jannepetter/hydroponicsMachine/presentations/midterm hydroP.pptx

## HydroponicsMachine

Github repo:
https://github.com/jannepetter/hydroponicsMachine
Sakari Väisänen, Oliver Niskala, Petri Hinttala and Janne Uutela

## Slide 2

Sketching

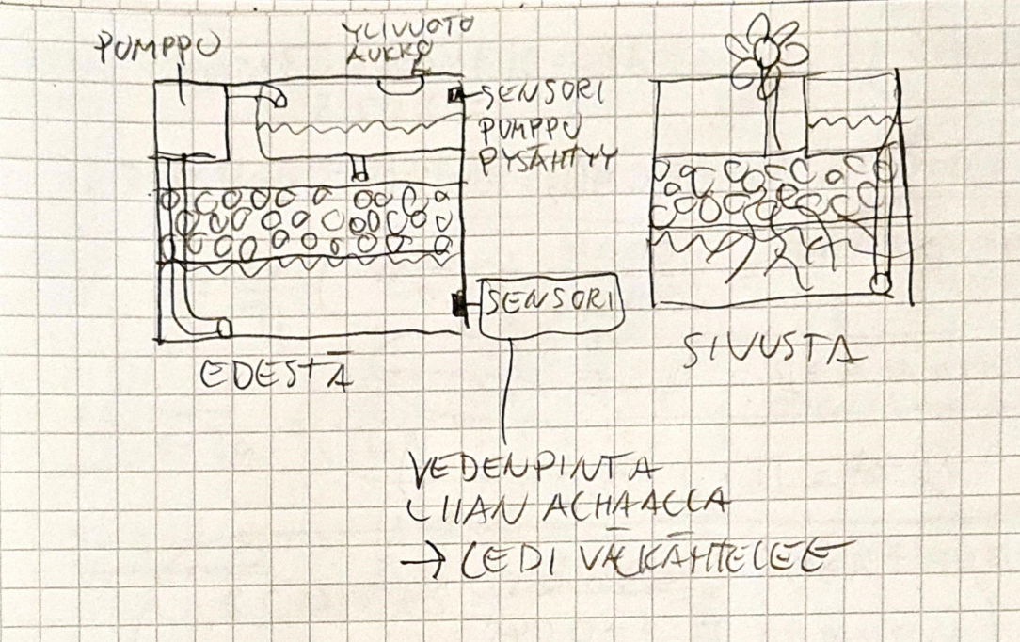
[picture p1: figure]
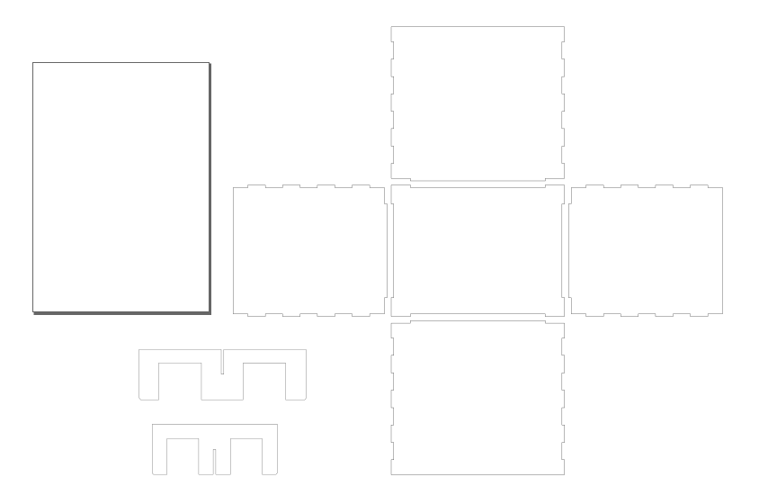
[picture p2: figure]

- maintank

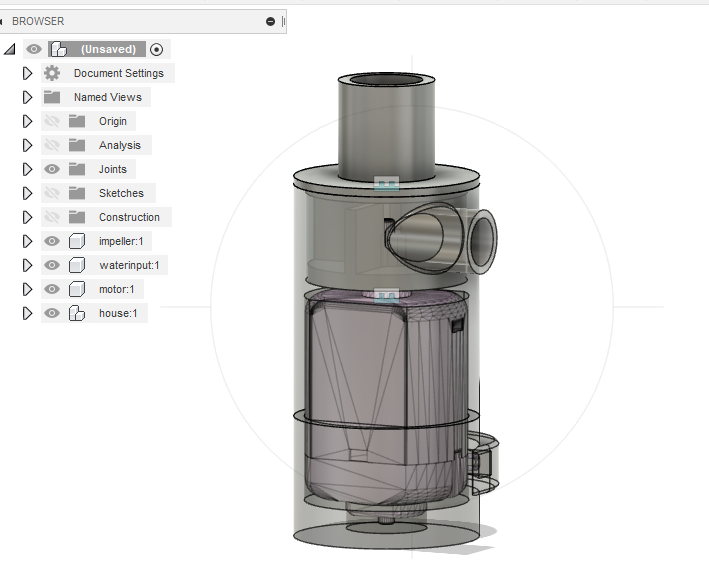
[picture p3: figure]

- pump

- minitank

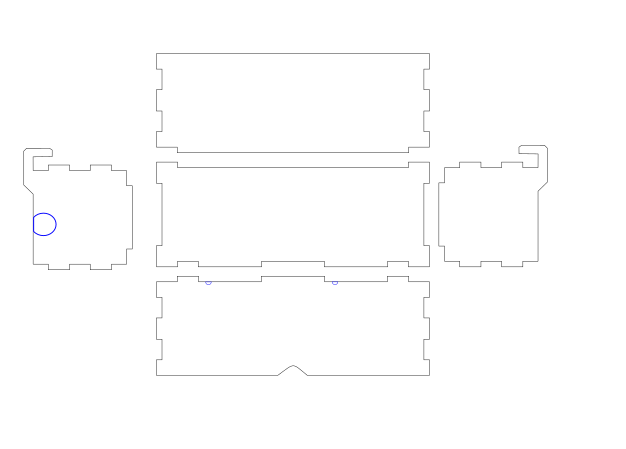
[picture p4: figure]

## Slide 3

Assembled main and minitank

- Holds water!
- We had minor cracks while gluing it together. (Kerf 0,18 and joint clearance 0,001). We will be using greater clearance for rest of the parts

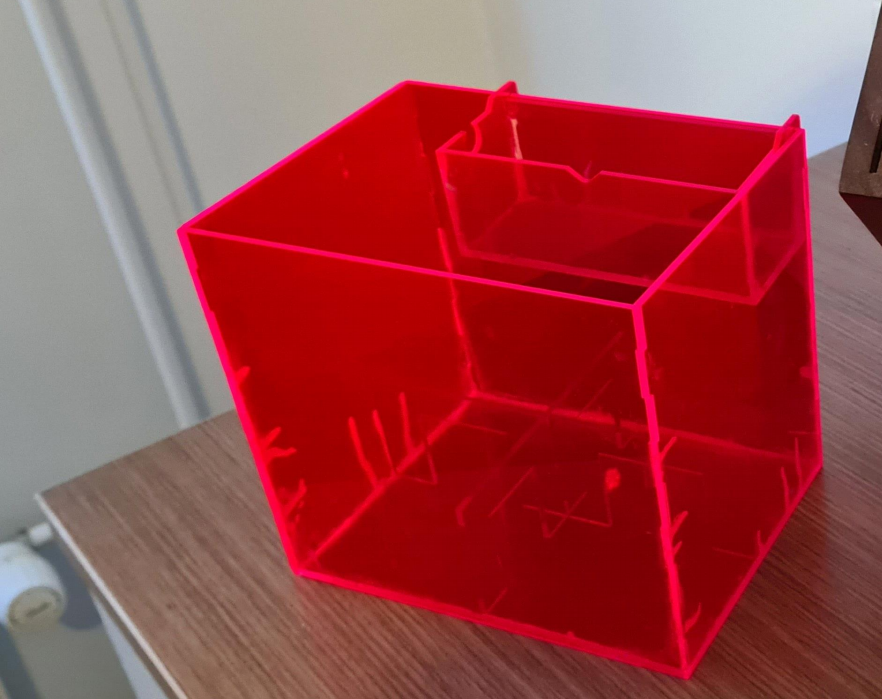
[picture p5: figure]
Kuva, joka sisältää kohteen teksti, pöytä, sisä, lattia Kuvaus luotu automaattisesti
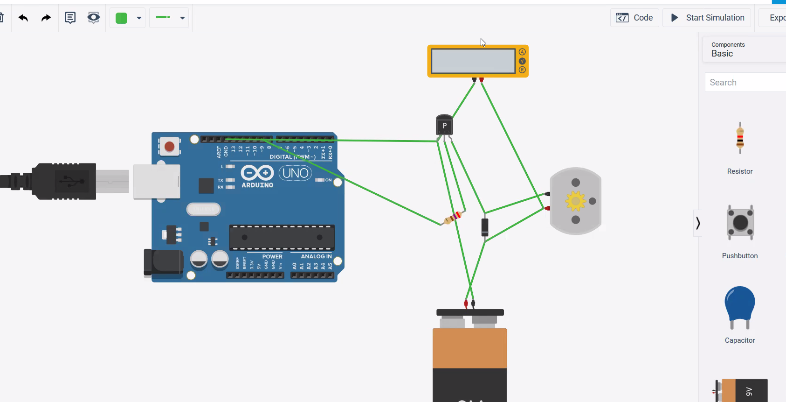
[picture p6: figure]

Current plan for the electronics
