jannepetter/hydroponicsMachine/3Dwaterpump/waterpumpv_inlet2.stl

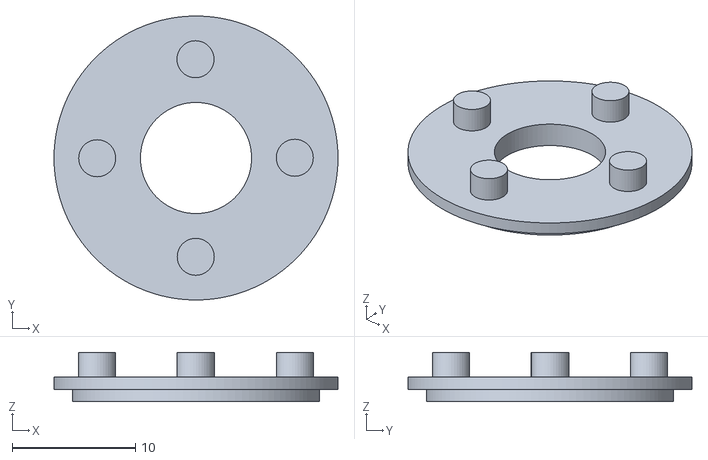
[picture p7: CAD file, 2021-04-11]
3Dwaterpump/waterpumpv_inlet2.stl
23.0 x 23.0 x 4.00
