jannepetter/hydroponicsMachine/3Dwaterpump/waterpumpv_inlet1.stl

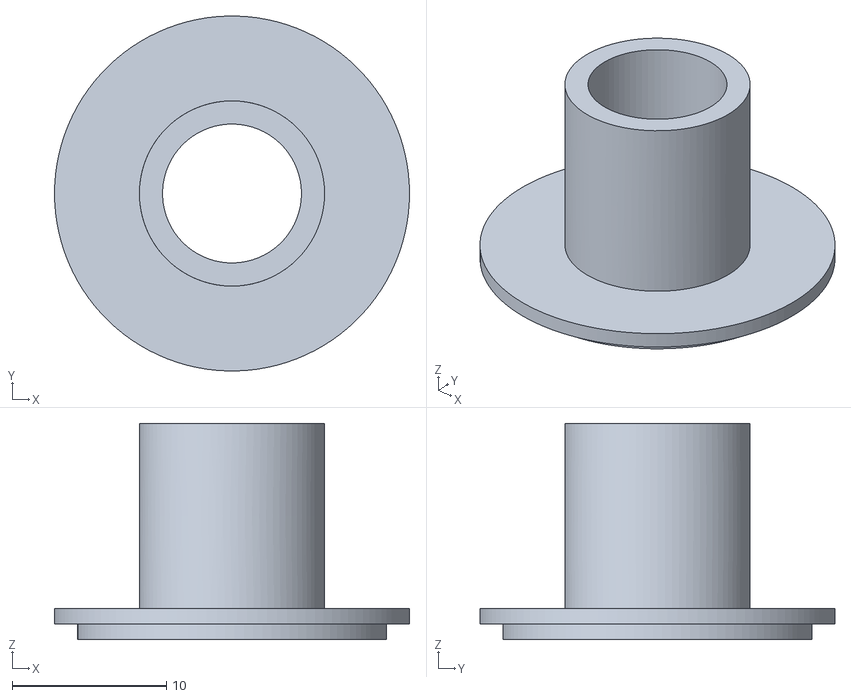
[picture p8: CAD file, 2021-04-11]
3Dwaterpump/waterpumpv_inlet1.stl
23.0 x 23.0 x 14.0
