jannepetter/hydroponicsMachine/3Dwaterpump/waterpumpv_impeller.stl

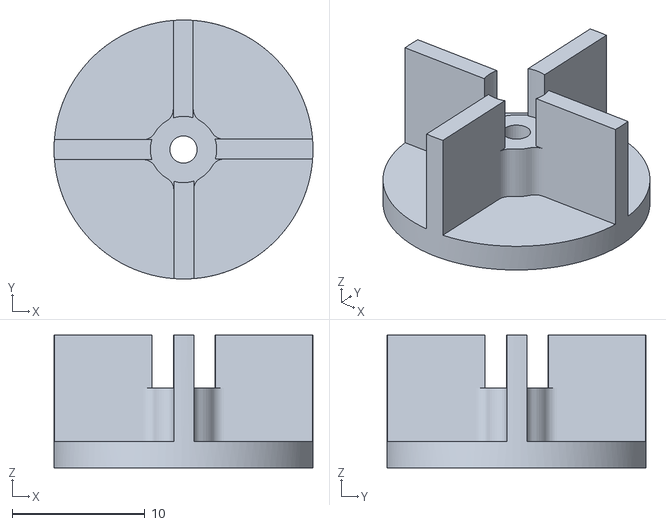
[picture p9: CAD file, 2021-04-11]
3Dwaterpump/waterpumpv_impeller.stl
19.5 x 19.5 x 10.0
