jannepetter/hydroponicsMachine/3Dwaterpump/waterpumpv_house.stl

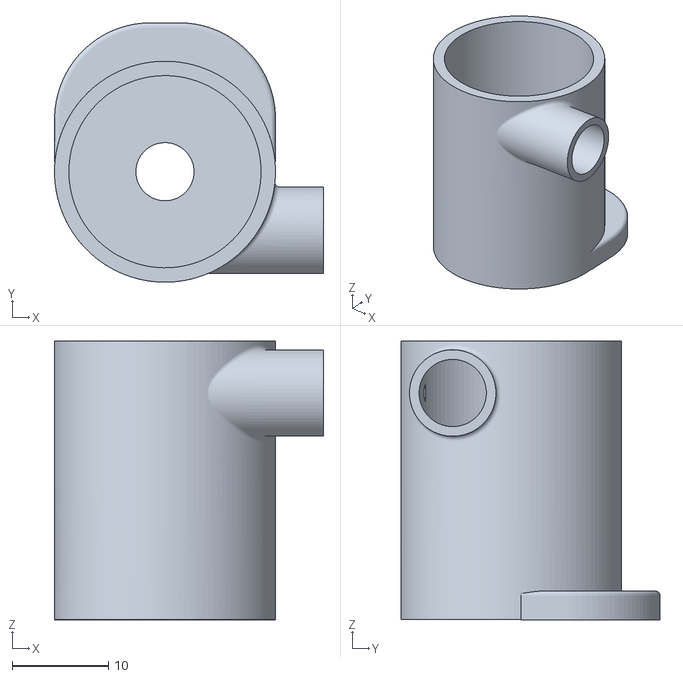
[picture p10: CAD file, 2021-04-11]
3Dwaterpump/waterpumpv_house.stl
28.0 x 27.0 x 29.0
