jannepetter/hydroponicsMachine/3Dwaterpump/waterpumpv_cover.stl

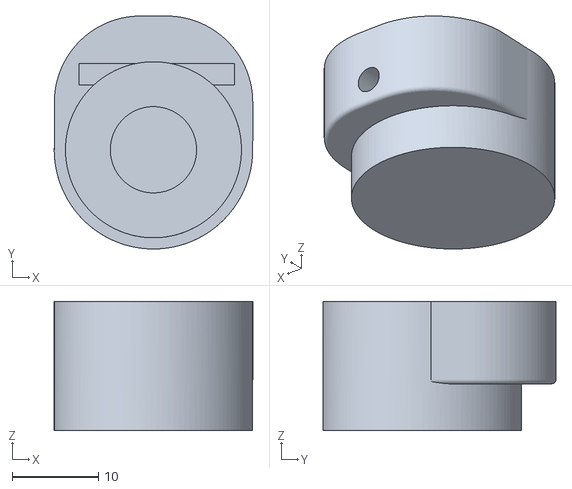
[picture p11: CAD file, 2021-04-11]
3Dwaterpump/waterpumpv_cover.stl
23.0 x 27.0 x 15.0
