jannepetter/hydroponicsMachine/(list of files, cad)

Other CAD files:
3Dwaterpump/waterpump.f3d
