jannepetter/hydroponicsMachine/kicad_hydroponics_cirtuit_test/kicad_hydroponics_cirtuit_test.kicad_pcb

## KiCad design kicad_hydroponics_cirtuit_test/kicad_hydroponics_cirtuit_test.kicad_pcb (2021-04-26)

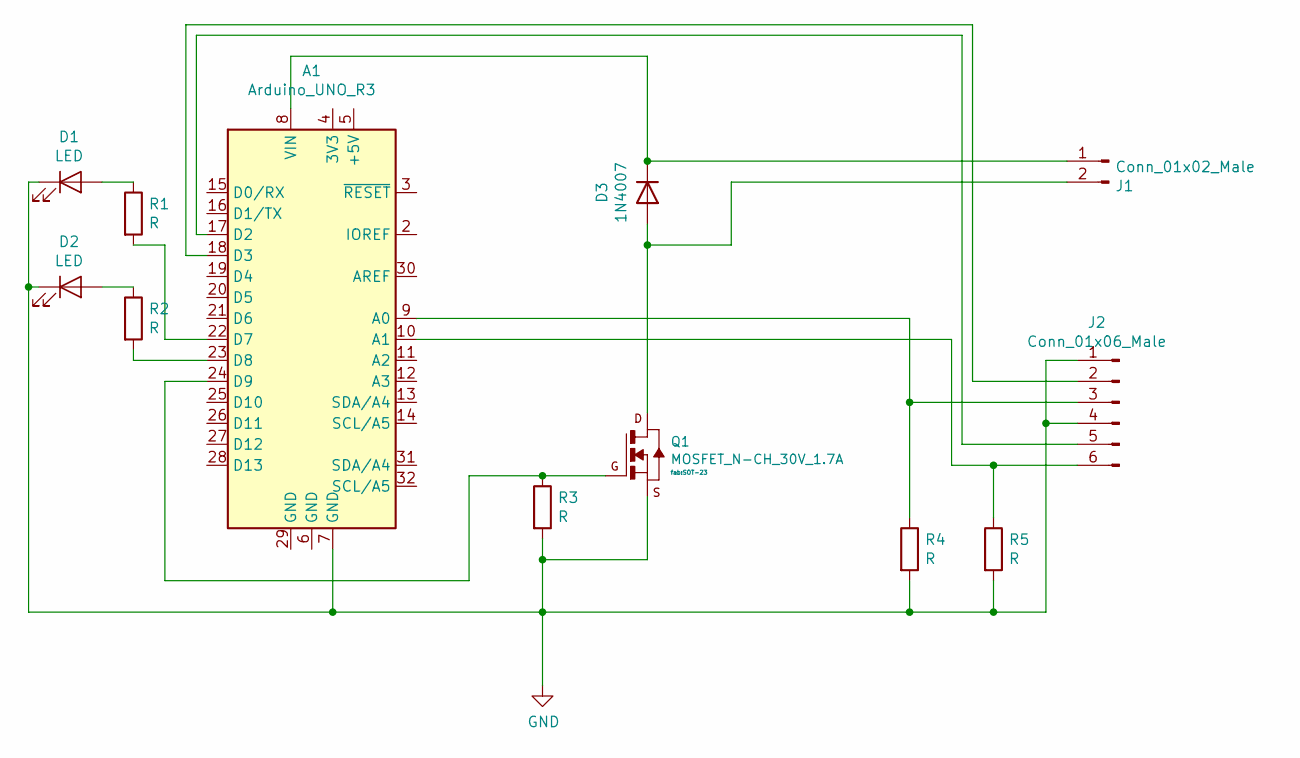
[picture p12: schematic kicad_hydroponics_cirtuit_test.sch]

Parts:
A1: Arduino_UNO_R3; Arduino_UNO_R3_WithMountingHoles
D1, D2: LED; LED_1206
D3: 1N4007; D_DO-41_SOD81_P10.16mm_Horizontal
J1: Conn_01x02_Male; Header_SMD_01x02_P2.54mm_Horizontal_Male
J2: Conn_01x06_Male; Header_SMD_01x06_P2.54mm_Horizontal_Male
Q1: MOSFET_N-CH_30V_1.7A; SOT-23
R1, R2, R3, R4, R5: R; R_1206

Connections:
GND: A1.7 (GND), D1.1 (K), D2.1 (K), J2.1, J2.4, Q1.2 (S), R3.2, R4.2, R5.2
unnamed: A1.8 (VIN), D3.1 (K), J1.1
unnamed: A1.9 (A0), J2.3, R4.1
unnamed: A1.10 (A1), J2.6, R5.1
unnamed: A1.17 (D2), J2.5
unnamed: A1.18 (D3), J2.2
unnamed: A1.22 (D7), R1.2
unnamed: A1.23 (D8), R2.2
unnamed: A1.24 (D9), Q1.1 (G), R3.1
unnamed: D1.2 (A), R1.1
unnamed: D2.2 (A), R2.1
unnamed: D3.2 (A), J1.2, Q1.3 (D)

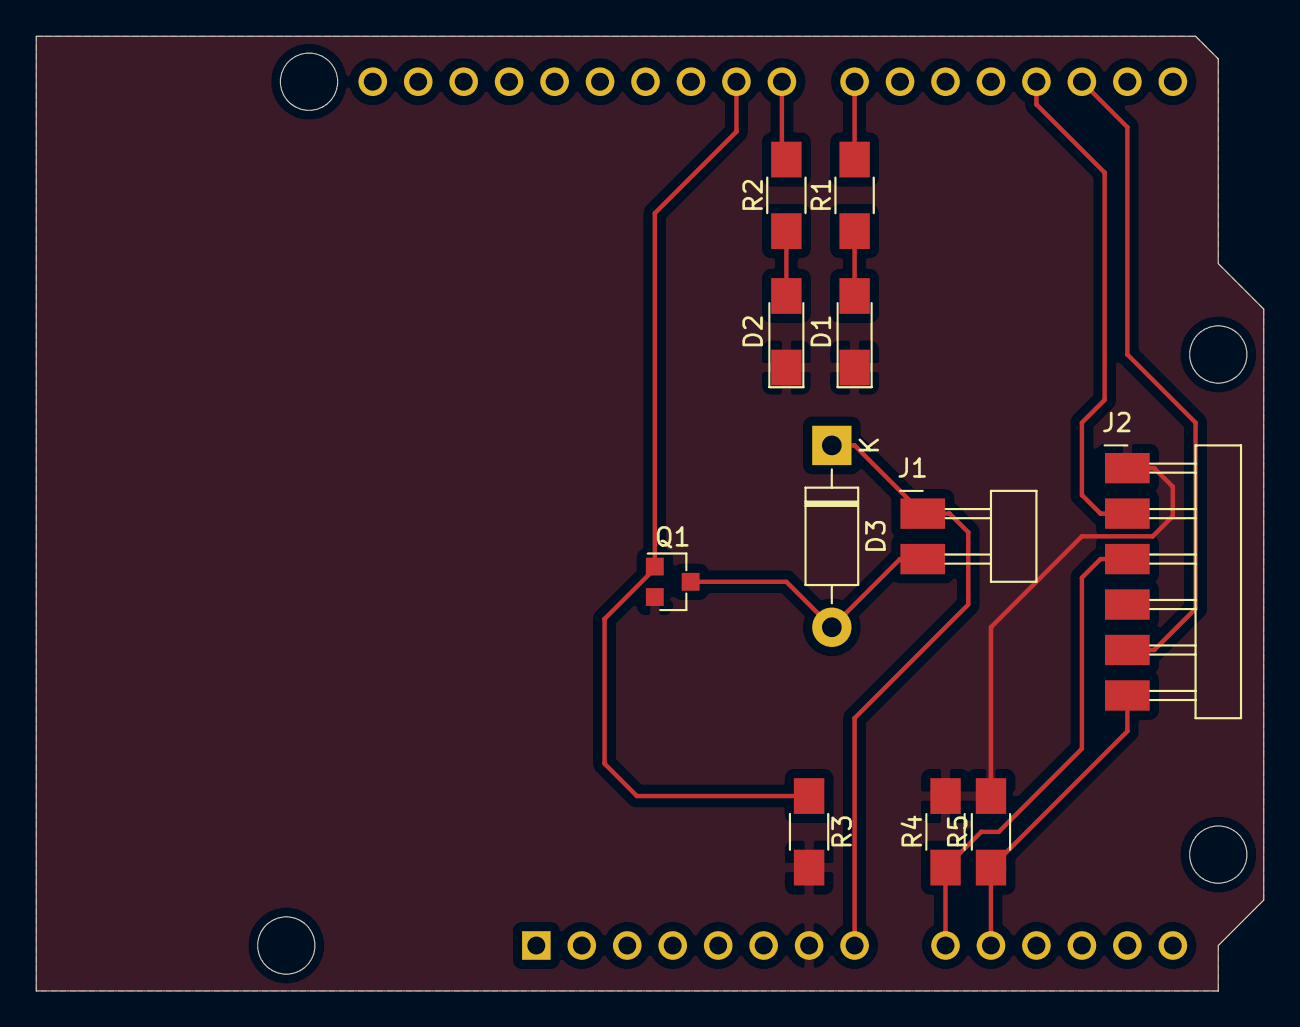
[picture p13: board kicad_hydroponics_cirtuit_test.kicad_pcb from above]

Board: 2 copper layers, 68.6 x 53.3 mm, 12 parts (1 on the bottom side), 12 nets.
