jannepetter/hydroponicsMachine/(commit log)

2021-03-30 Fusion 360 3D sketch for water pump
    [waterpump.f3d]
2021-03-31 Motor cover design update to enable assembly
    [waterpump.f3d]
2021-04-06 Optional water inlet to mount pump to bottom.
    [waterpump.f3d]
2021-04-07 Fix pump cover as component Add components stl files
    [waterpump.f3d, waterpumpv_cover.stl, waterpumpv_house.stl, waterpumpv_impeller.stl, waterpumpv_inlet1.stl, waterpumpv_inlet2.stl]
2021-04-20 Uploaded KiCad files that need to be improved
    [kicad_hydroponics_cirtuit_test.kicad_pcb, kicad_hydroponics_cirtuit_test.sch]
2021-04-21 Updated to use SMD components except diode 1N4007 is through hole. Water level sensor powering from Arduino digital pins to prevent sensor electrochemical corrosion
    [kicad_hydroponics_cirtuit_test.kicad_pcb, kicad_hydroponics_cirtuit_test.sch]
2021-04-22 arduino box added
2021-04-25 Uploaded the code file for Arduino
2021-04-26 Add gerber files
    [kicad_hydroponics_cirtuit_test.kicad_pcb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]
2021-04-28 modified and added variables, made the code clearer and added max on-time for the pump
